Loreton/pressControl/Kicad/2025/pdf/PressControl_ESP32_2relay.pdf

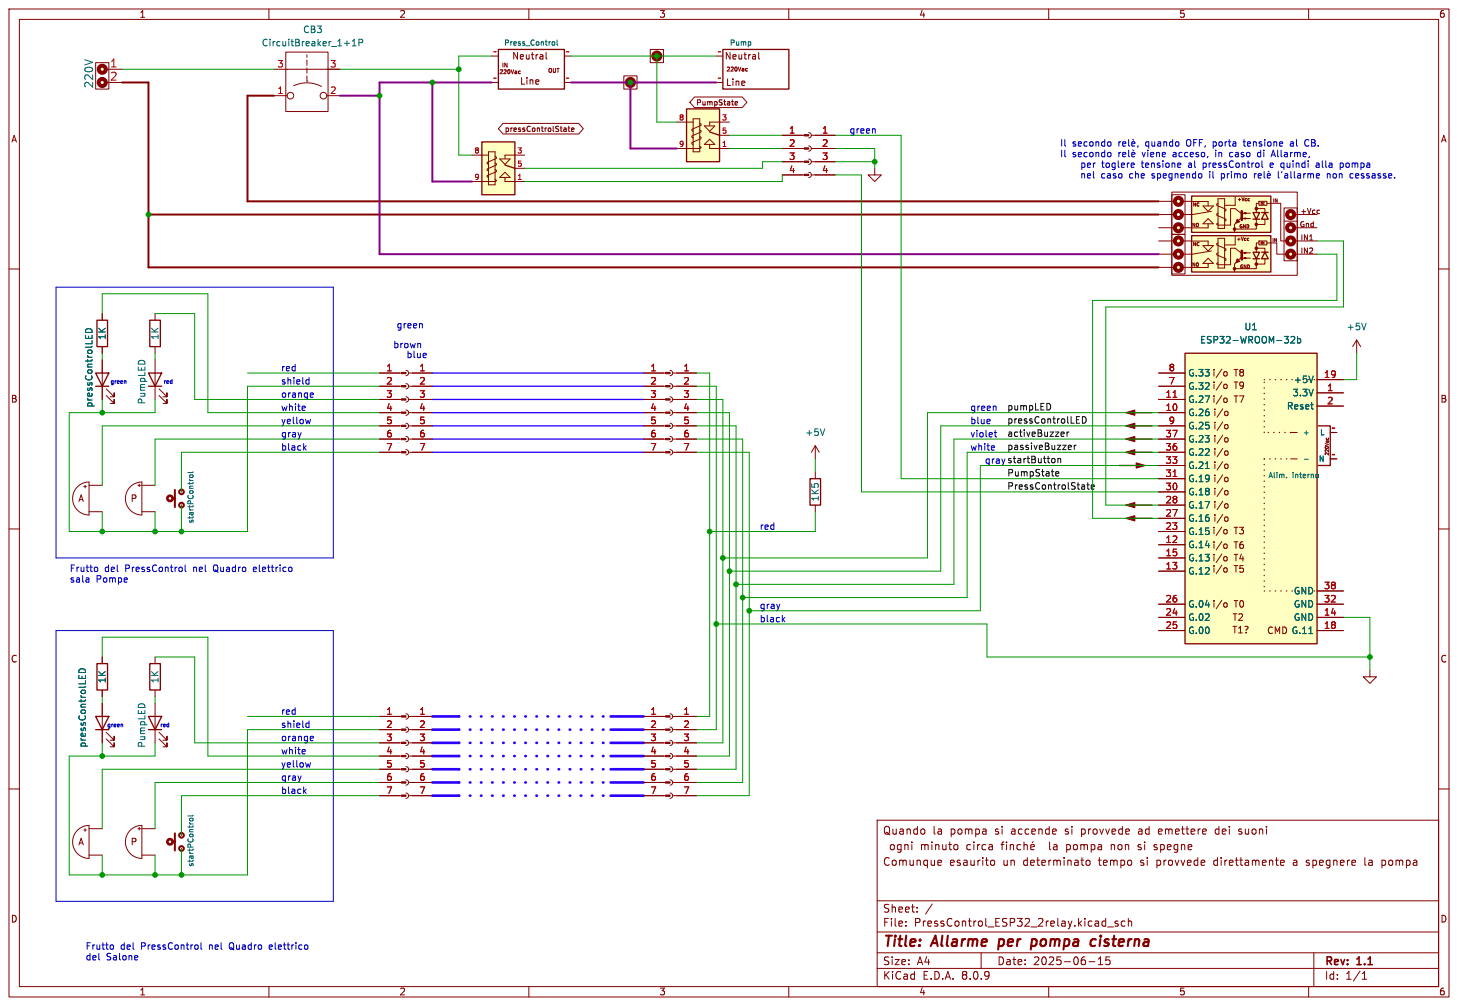
[picture p1: page 1]

Il secondo þÿrelè, quando OFF, porta tensione al CB.

Id: 1/1 Title: Allarme per pompa cisterna
