Loreton/pressControl/Kicad/2024/pdf/PressControl_vanoPompe_20240917.pdf

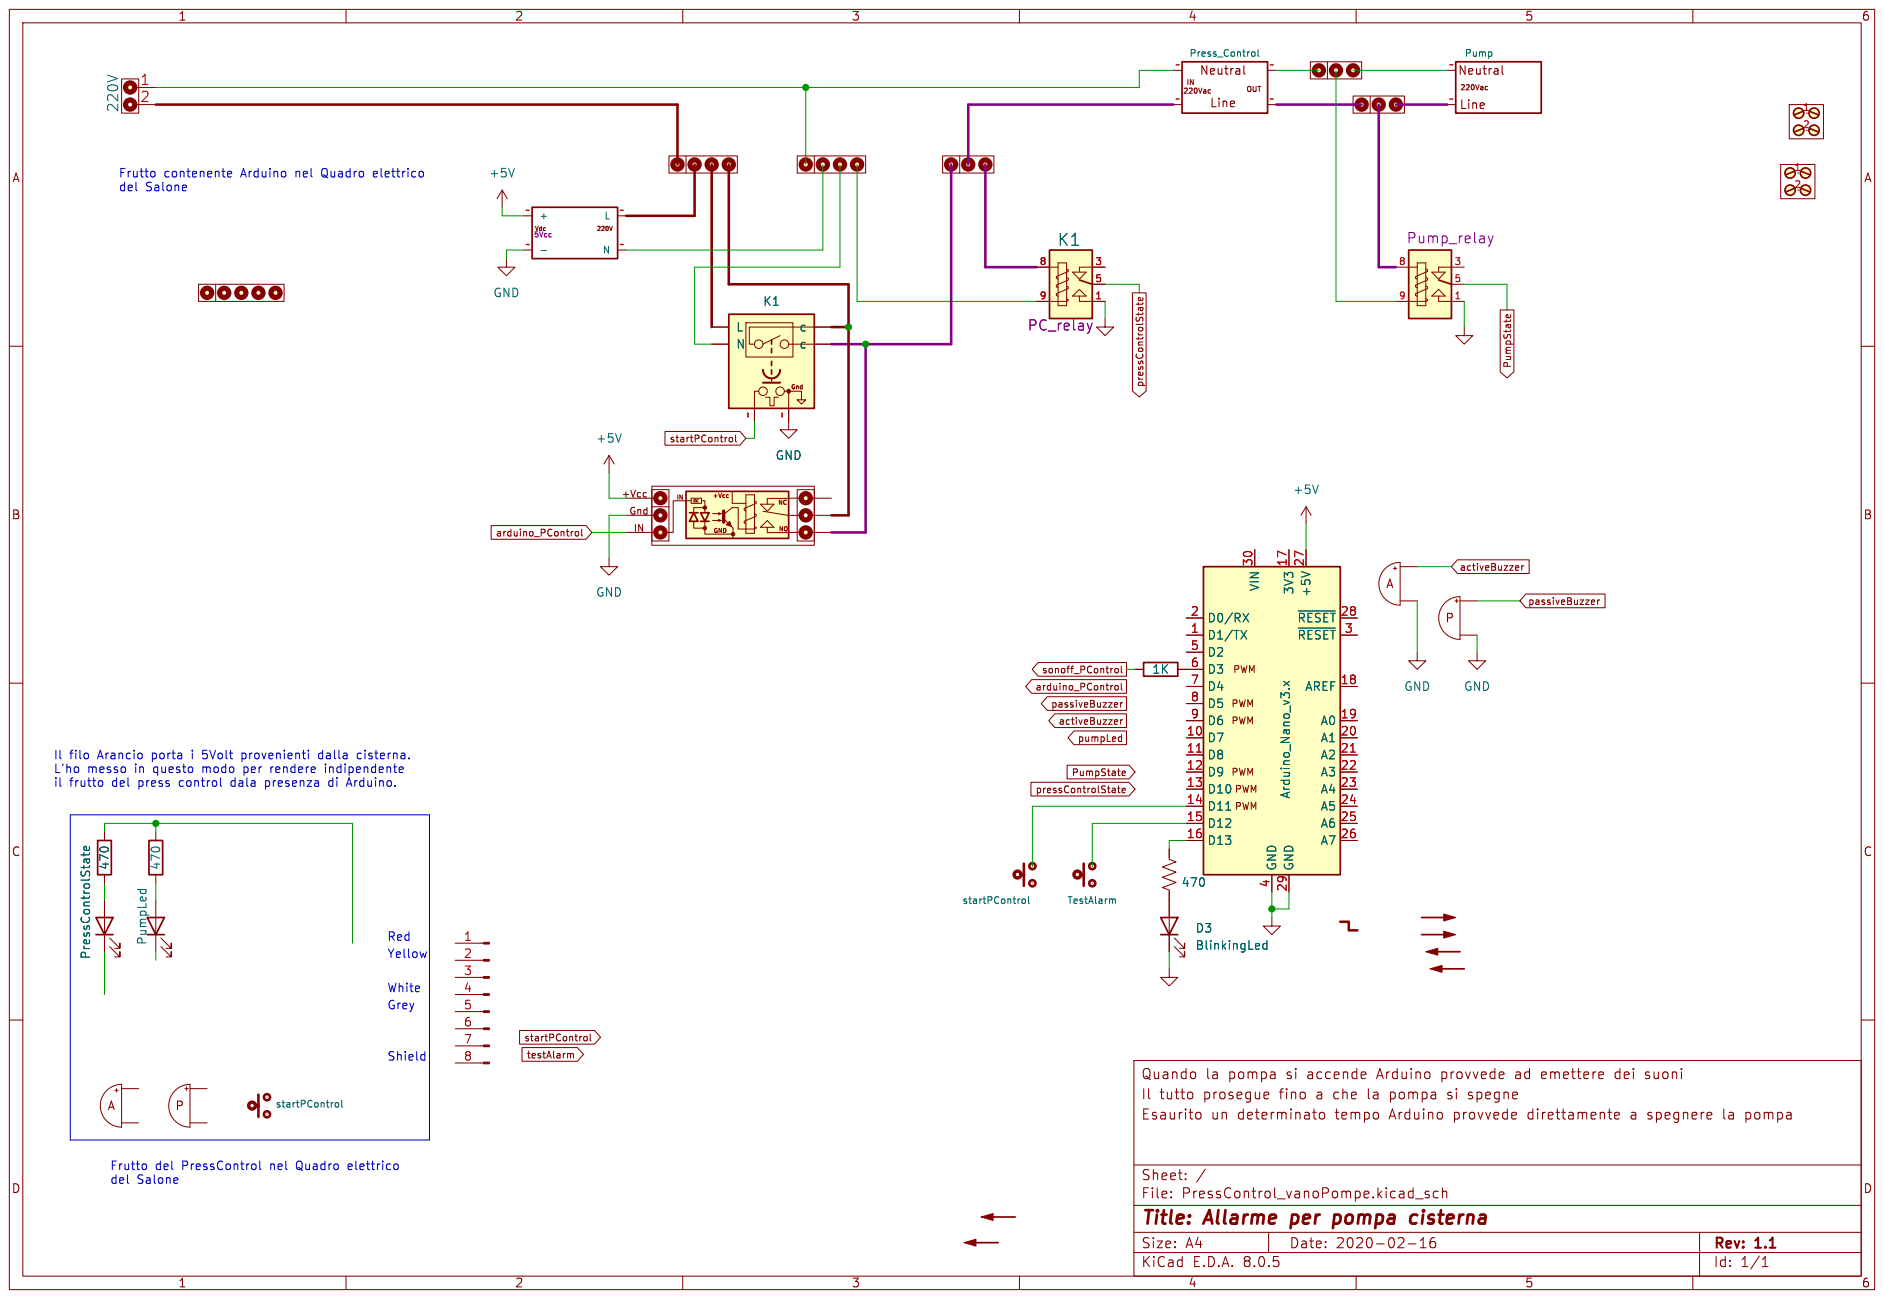
[picture p3: page 1]

R+Vcc +Vcc GND Gnd

Id: 1/1 Title: Allarme per pompa cisterna
