Loreton/pressControl/Kicad/2024/pdf/PressControl.pdf

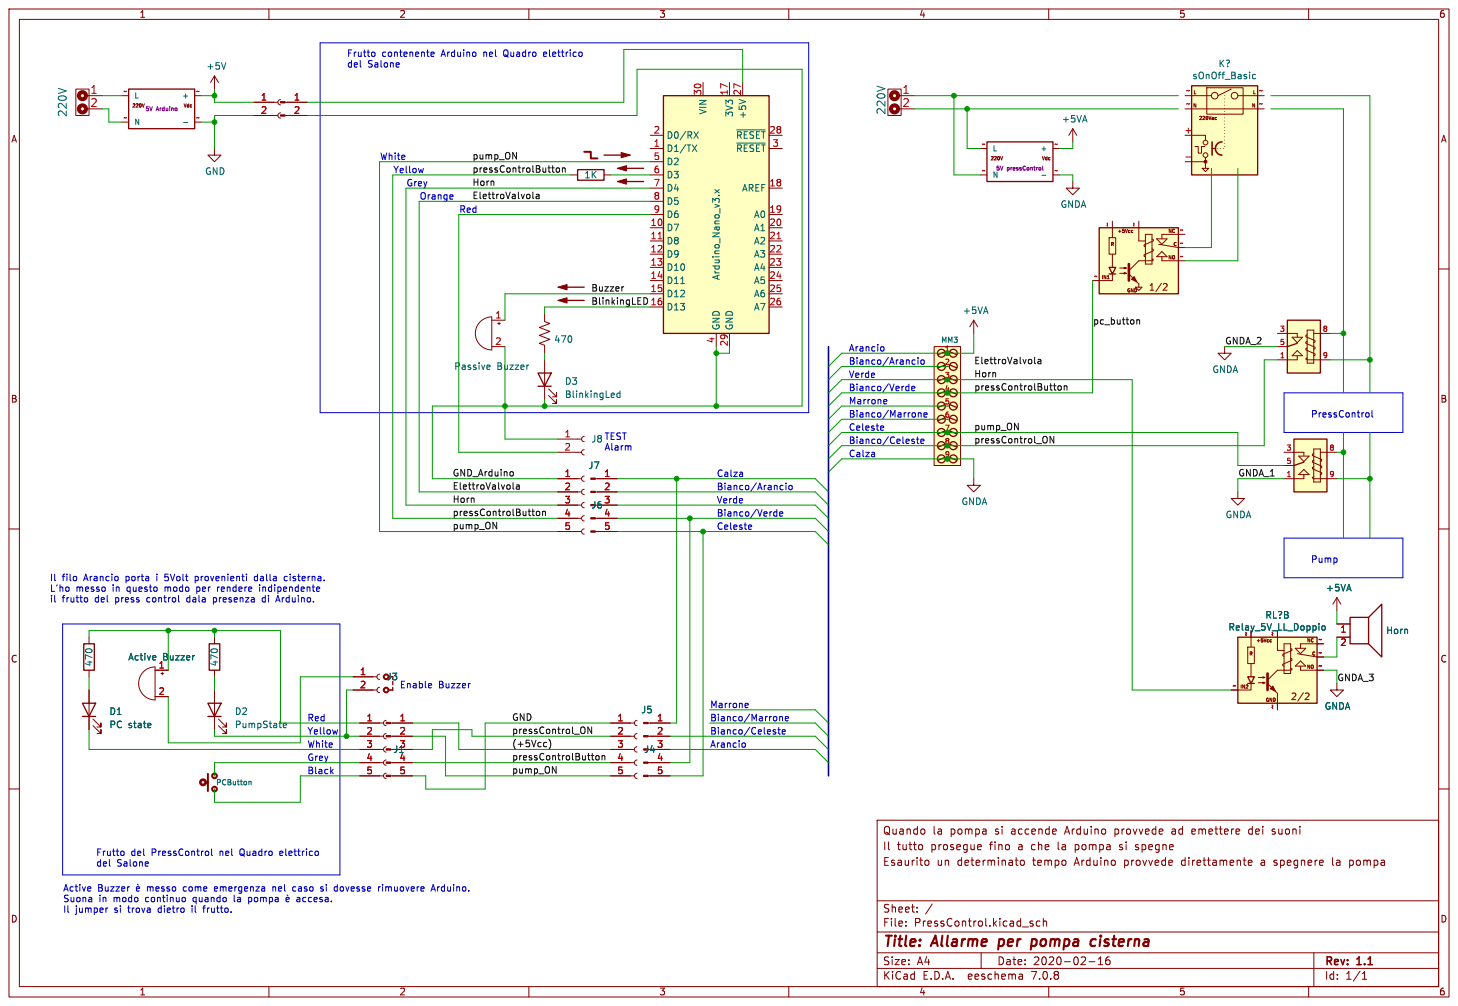
[picture p5: page 1]

Bianco/Arancio Bianco/Marrone Calza Bianco/Celeste Celeste

Il jumper si trova dietro il frutto.

Id: 1/1 Title: Allarme per pompa cisterna
