Loreton/pressControl/Kicad/2025/PressControl_ESP32_2relay.kicad_sch

## KiCad design Kicad/2025/PressControl_ESP32_2relay.kicad_sch (2025-08-08)

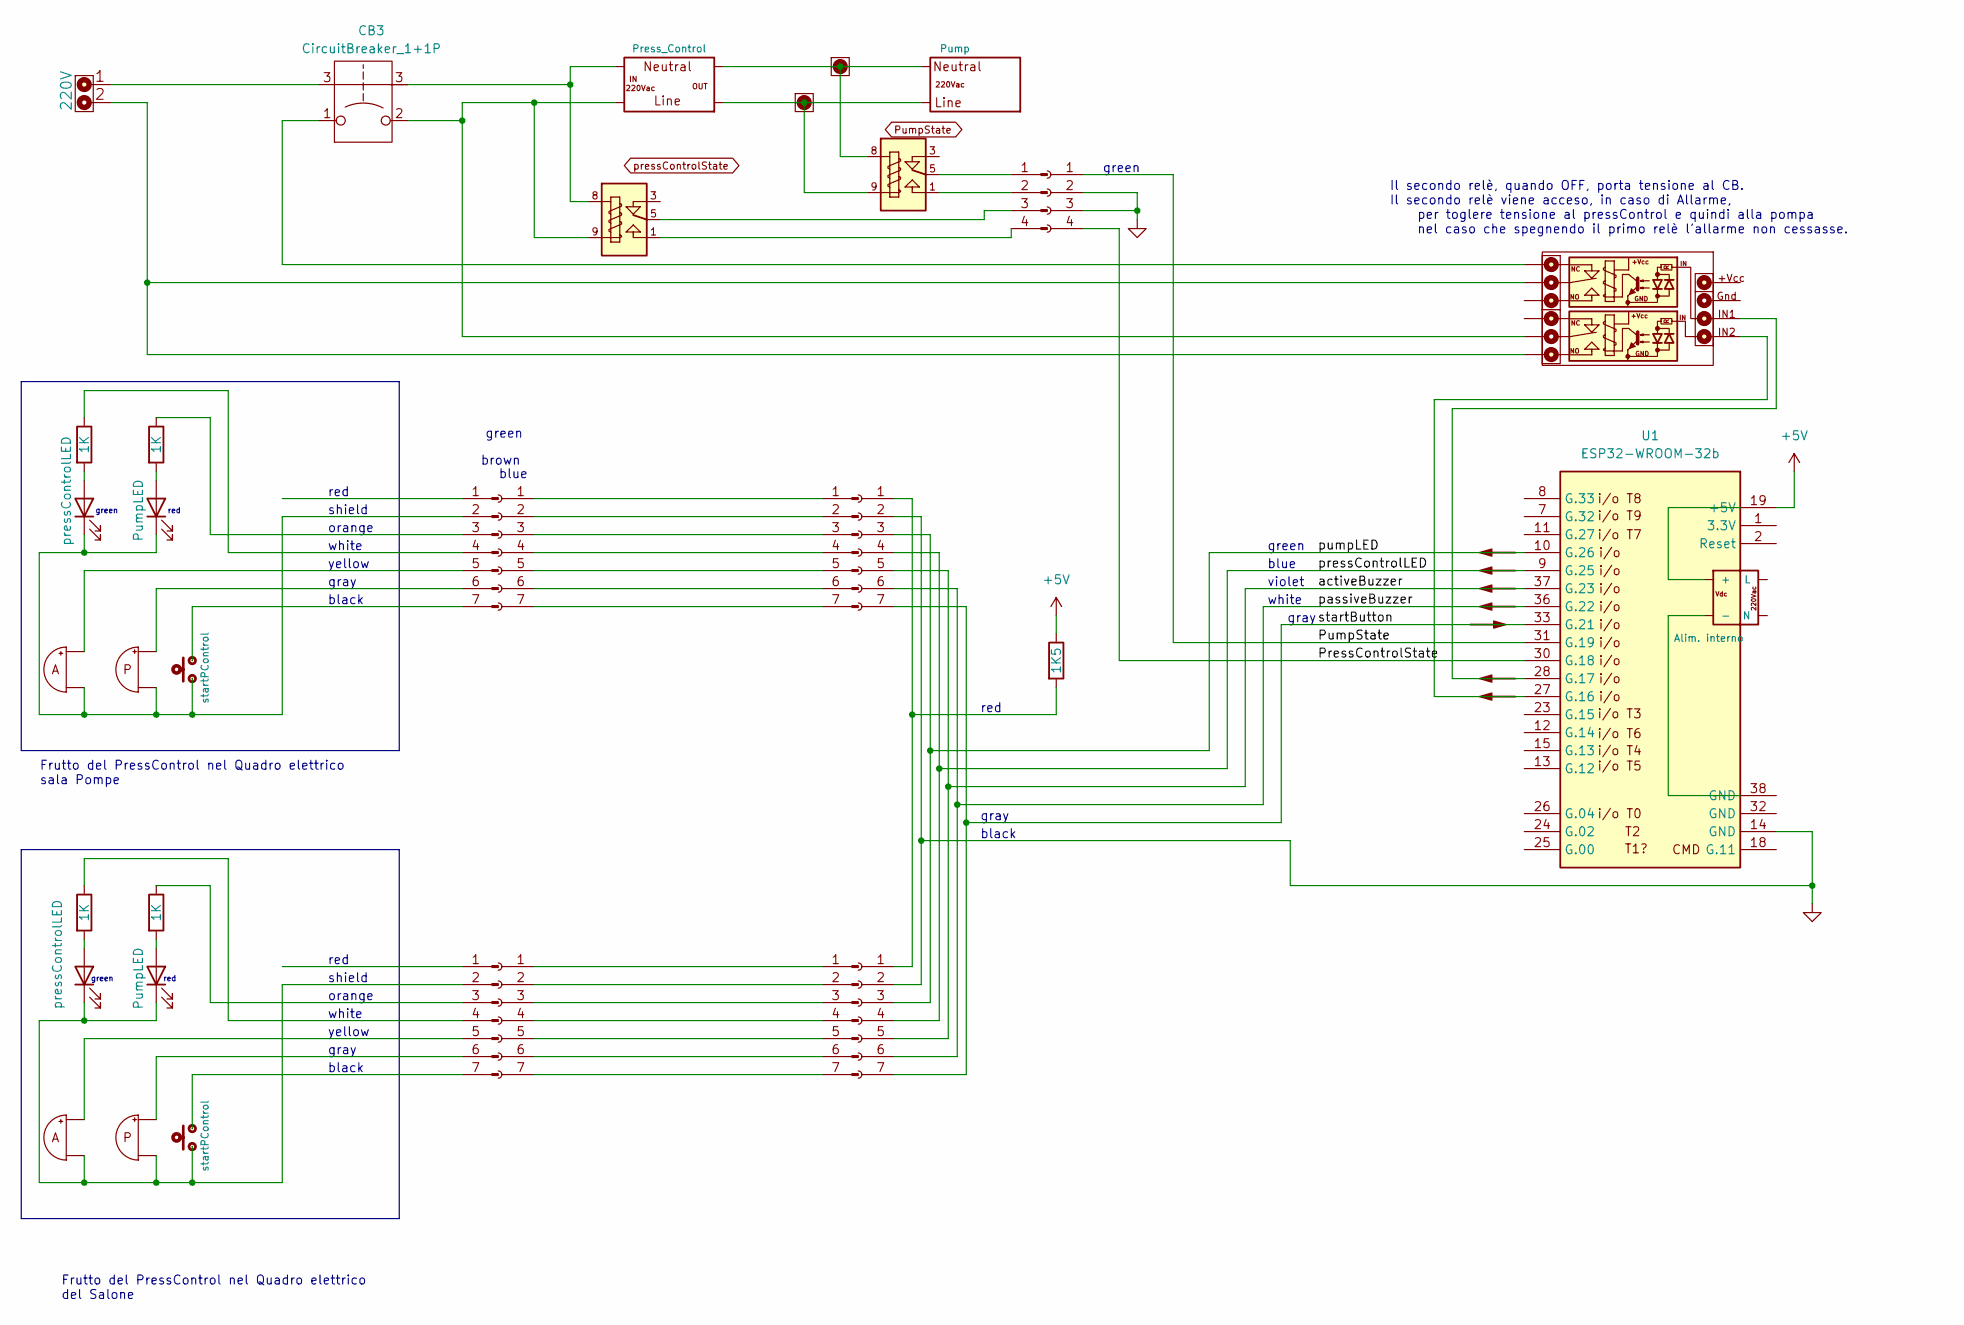
[picture p7: schematic PressControl_ESP32_2relay.kicad_sch]

Parts:
Al2: Alim. interno
BZ1, BZ3: Buzzer Active
BZ2, BZ4: Buzzer
CB3: CircuitBreaker_1+1P
D1, D4: pressControlLED
D2, D5: PumpLED
J1, J3, J9, J14, J16: Conn_01x08_Pin
J2, J8, J10, J11, J15: Conn_01x08_Socket
J12, J13: SIP_01
K1, K2: RELAY_1RT
K3: Relayx2_Module
P1: Pump
P2: Press_Control
R1, R3, R5, R6: 1K
R4: 1K5
SW2, SW3: startPControl
U1: ESP32-WROOM-32b; ESP32-WROOM-32

Connections:
+5V: R4.1, U1.19 (+5V)
GND: J2.2, J2.3, J10.2, J11.2, U1.14 (GND)
unnamed: BZ1., BZ2., D1.1 (K), D2.1 (K), J3.2, J3.5, SW3.1
unnamed: BZ2., J3.6
unnamed: BZ3., BZ4., D4.1 (K), D5.1 (K), J9.2, J9.5, SW2.1
unnamed: BZ4., J9.6
unnamed: CB3.1, K3.1
unnamed: CB3.2, K1.9, K3.2, P2.~
unnamed: CB3.3, K1.8, P2.~
unnamed: D1.2 (A), R3.2
unnamed: D2.2 (A), R5.2
unnamed: D4.2 (A), R1.2
unnamed: D5.2 (A), R6.2
unnamed: J1.1, K2.5 (C1)
unnamed: J1.2, K2.1 (T1)
unnamed: J1.3, K1.5 (C1)
unnamed: J1.4, K1.1 (T1)
unnamed: J3.3, R5.1
unnamed: J3.4, R3.1
unnamed: J3.7, SW3.2
unnamed: J9.3, R6.1
unnamed: J9.4, R1.1
unnamed: J9.7, SW2.2
unnamed: J10.1, J11.1, R4.2
unnamed: J12.1, K2.9, P1.~, P2.~
unnamed: J13.1, K2.8, P1.~, P2.~
unnamed: J14.1, J15.1
unnamed: J14.2, J15.2
unnamed: J14.3, J15.3
unnamed: J14.4, J15.4
unnamed: J14.5, J15.5
unnamed: J14.6, J15.6
unnamed: J14.7, J15.7
unnamed: J8.1, J16.1
unnamed: J8.2, J16.2
unnamed: J8.3, J16.3
unnamed: J8.4, J16.4
unnamed: J8.5, J16.5
unnamed: J8.6, J16.6
unnamed: J8.7, J16.7
unnamed: K3.2, K3.3
unnamed: K3.3, U1.28 (G.17)
unnamed: K3.4 (IN2), U1.27 (G.16)
PumpState: J2.1, U1.31 (G.19)
activeBuzzer: J10.5, J11.5, U1.37 (G.23)
passiveBuzzer: J10.6, J11.6, U1.36 (G.22)
pressControlLED: J10.4, J11.4, U1.9 (G.25)
pressControlState: J2.4, U1.30 (G.18)
pumpLED: J10.3, J11.3, U1.10 (G.26)
startButton: J10.7, J11.7, U1.33 (G.21)

Notes on the sheet:
red
violet
green
gray
white
Il secondo relè, quando OFF, porta tensione al CB. Il secondo relè viene acceso, in caso di Allarme, per toglere tensione al pressControl e quindi alla pompa nel caso che spegnendo il primo relè l'allarme non cessasse.
shield
black
black
Frutto del PressControl nel Quadro elettrico sala Pompe
blue
brown
orange
yellow
red
Frutto del PressControl nel Quadro elettrico del Salone
