Loreton/pressControl/Kicad/2024/prev/PressControl_V2.kicad_sch

## KiCad design Kicad/2024/prev/PressControl_V2.kicad_sch (2025-04-18)

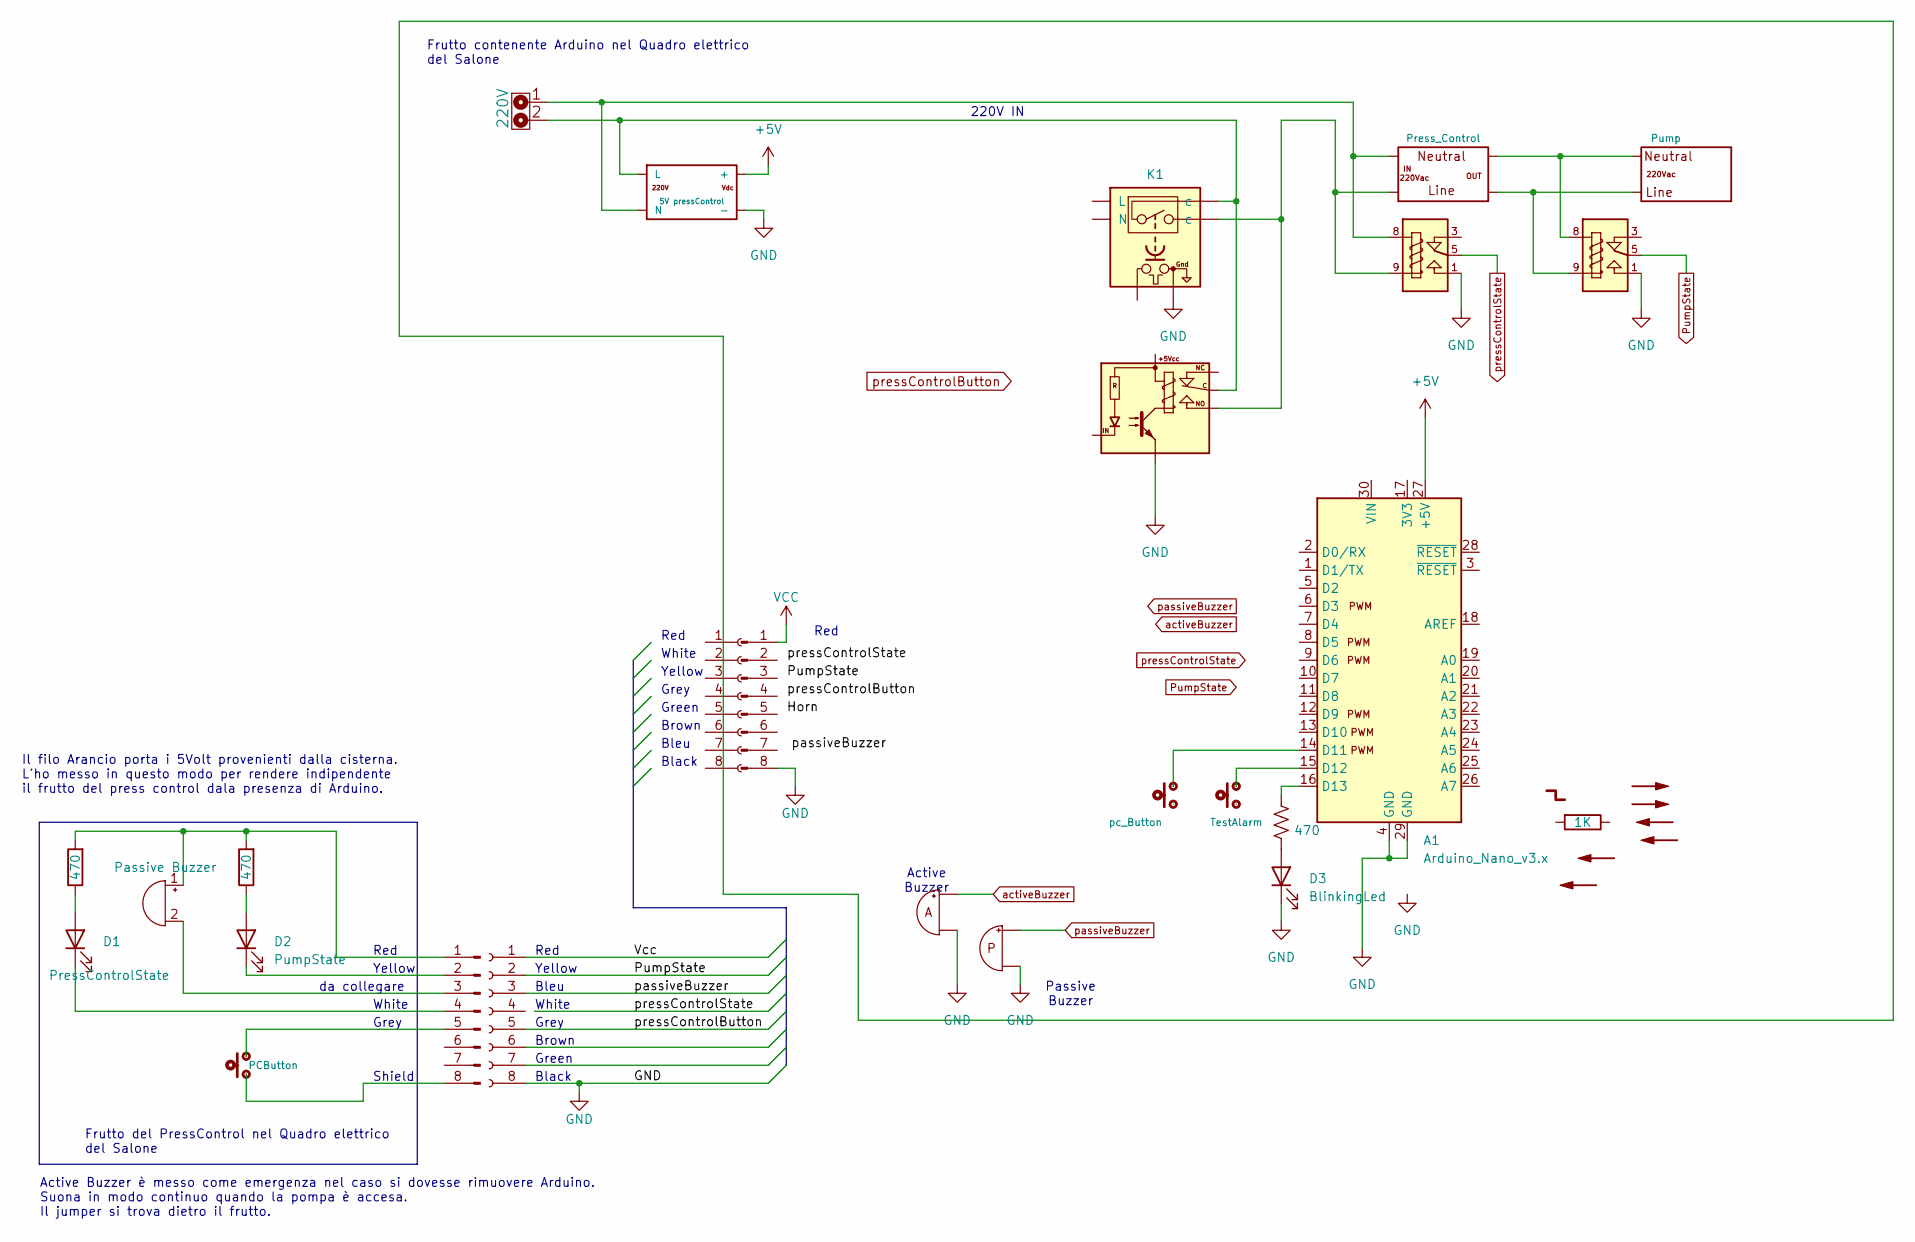
[picture p8: schematic PressControl_V2.kicad_sch]

Parts:
A1: Arduino_Nano_v3.x; Arduino_Nano
BZ1: Passive Buzzer
BZ3: Buzzer Active
BZ4: Buzzer
D1: PressControlState
D2: PumpState
D3: BlinkingLed
J1, J6: Conn_01x08_Pin
J2, J5: Conn_01x08_Socket
K1: sOnOff_ClearContacts
P1: Pump
P2: Press_Control
RL1: Relay_5V_LL
SW1: TestAlarm
SW2: pc_Button

Connections:
+5V: A1.27 (+5V)
GND: A1.4 (GND), A1.29 (GND), BZ3., BZ4., D3.1 (K), J2.8, J6.8, K1.~, RL1.~
unnamed: A1.14 (D11), SW2.2
unnamed: A1.15 (D12), SW1.2
unnamed: BZ1.1 (-), J1.1
unnamed: BZ1.2 (+), J1.3
unnamed: D1.1 (K), J1.4
unnamed: D2.1 (K), J1.2
unnamed: K1. (L), P2.~, RL1.~
unnamed: P1.~, P2.~
PumpState: J2.2
Vcc: J2.1, J6.1
activeBuzzer: BZ3.
passiveBuzzer: BZ4., J2.3
pressControlButton: J2.5

Notes on the sheet:
Brown
220V IN
da collegare
Red
Frutto del PressControl nel Quadro elettrico del Salone
White
Yellow
Grey
Bleu
Passive Buzzer
Green
Frutto contenente Arduino nel Quadro elettrico del Salone
Active Buzzer è messo come emergenza nel caso si dovesse rimuovere Arduino. Suona in modo continuo quando la pompa è accesa. Il jumper si trova dietro il frutto.
Il filo Arancio porta i 5Volt provenienti dalla cisterna. L'ho messo in questo modo per rendere indipendente il frutto del press control dala presenza di Arduino.
Shield
Active Buzzer
Black
Red
