Loreton/pressControl/Kicad/2024/prev/PressControl_con_Alim_v2.kicad_sch

## KiCad design Kicad/2024/prev/PressControl_con_Alim_v2.kicad_sch (2025-04-18)

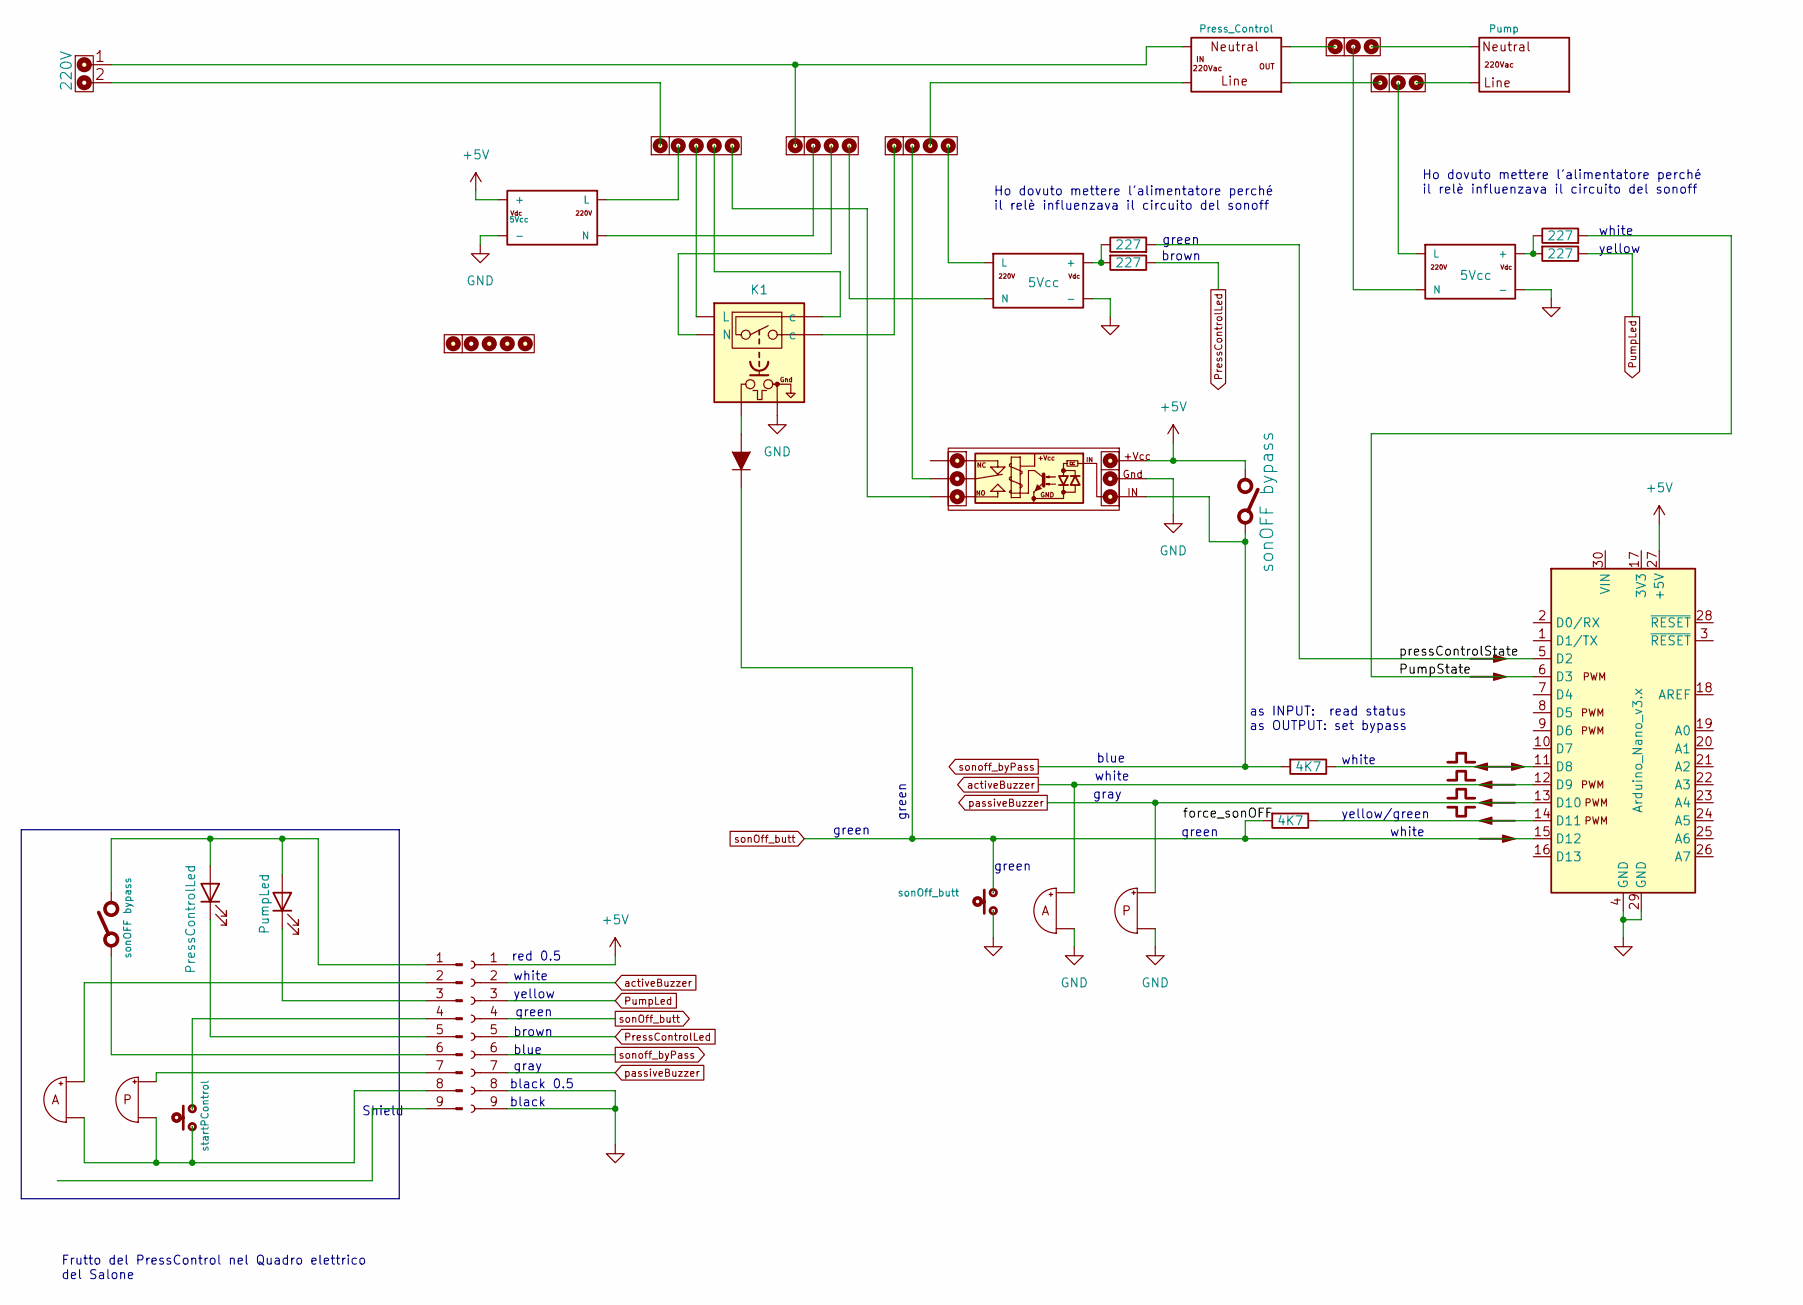
[picture p9: schematic PressControl_con_Alim_v2.kicad_sch]

Parts:
A1: Arduino_Nano_v3.x; Arduino_Nano
Al_5Vcc1, Al_5Vcc2: Alimentatore; 5Vcc
BZ1, BZ3: Buzzer Active
BZ2, BZ4: Buzzer
D1: PressControlLed
D2: PumpLed
D4: DIODE
J1, J2, J4, J5, J6: SIP_05
J3: Conn_01x08_Pin
J7: SIP_04
J10: Conn_01x08_Socket
K1: sOnOff_ClearContacts
K2: Relayx1_Module
P1: Pump
P2: Press_Control
R1, R3, R4, R5: 227
R7: 4K7
SW2: sonOff_butt
SW3: startPControl
SW4, SW5: sonOFF bypass
SW6, SW7, SW8, SW9: Pulse

Connections:
+5V: A1.27 (+5V), J10.1, K2.1, SW4.2
GND: A1.4 (GND), A1.29 (GND), Al_5Vcc1.~, Al_5Vcc2.~, BZ3., BZ4., J10.8, J10.9, K1.~, K2.2, SW2.1
unnamed: A1.11 (D8), R7.1
unnamed: Al_5Vcc1.~, J2.4, J4.4, R3.2, R5.1
unnamed: Al_5Vcc2.~, J5.2, J6.2, R1.1, R4.2
unnamed: BZ1., BZ2., J3.2, J3.8, SW3.1
unnamed: BZ2., J3.7
unnamed: D1.1 (K), J3.5
unnamed: D1.2 (A), D2.2 (A), J3.1, SW5.2
unnamed: D2.1 (K), J3.3
unnamed: D4.1 (A), K1.~
unnamed: J2.1, K1. (L)
unnamed: J2.2, K2.2
unnamed: J2.3, P2.~
unnamed: J3.4, SW3.2
unnamed: J3.6, SW5.1
unnamed: J4.1, P2.~
unnamed: J4.3, K1. (L)
unnamed: J5.1, P2.~
unnamed: J5.3, P1.~
unnamed: J6.1, P2.~
unnamed: J6.3, P1.~
unnamed: J7.3, K1. (L)
unnamed: J7.4, K1. (L)
unnamed: J7.5, K2.3
PressControlLed: J10.5, R3.1
PumpLed: J10.3, R4.1
PumpState: A1.6 (D3), R1.2
activeBuzzer: A1.12 (D9), BZ3., J10.2
passiveBuzzer: A1.13 (D10), BZ4., J10.7
pressControlState: A1.5 (D2), R5.2
sonOff_butt: A1.15 (D12), D4.2 (K), J10.4, SW2.2
sonoff_byPass: J10.6, K2.3, R7.2, SW4.1

Notes on the sheet:
green
white
yellow/green
as INPUT: read status as OUTPUT: set bypass
brown
black
black 0.5
Ho dovuto mettere l'alimentatore perché il relè influenzava il circuito del sonoff
gray
yellow
red 0.5
blue
Shield
Frutto del PressControl nel Quadro elettrico del Salone
