Loreton/pressControl/Kicad/2024/prev/PressControl_vanoPompe.kicad_sch

## KiCad design Kicad/2024/prev/PressControl_vanoPompe.kicad_sch (2025-04-18)

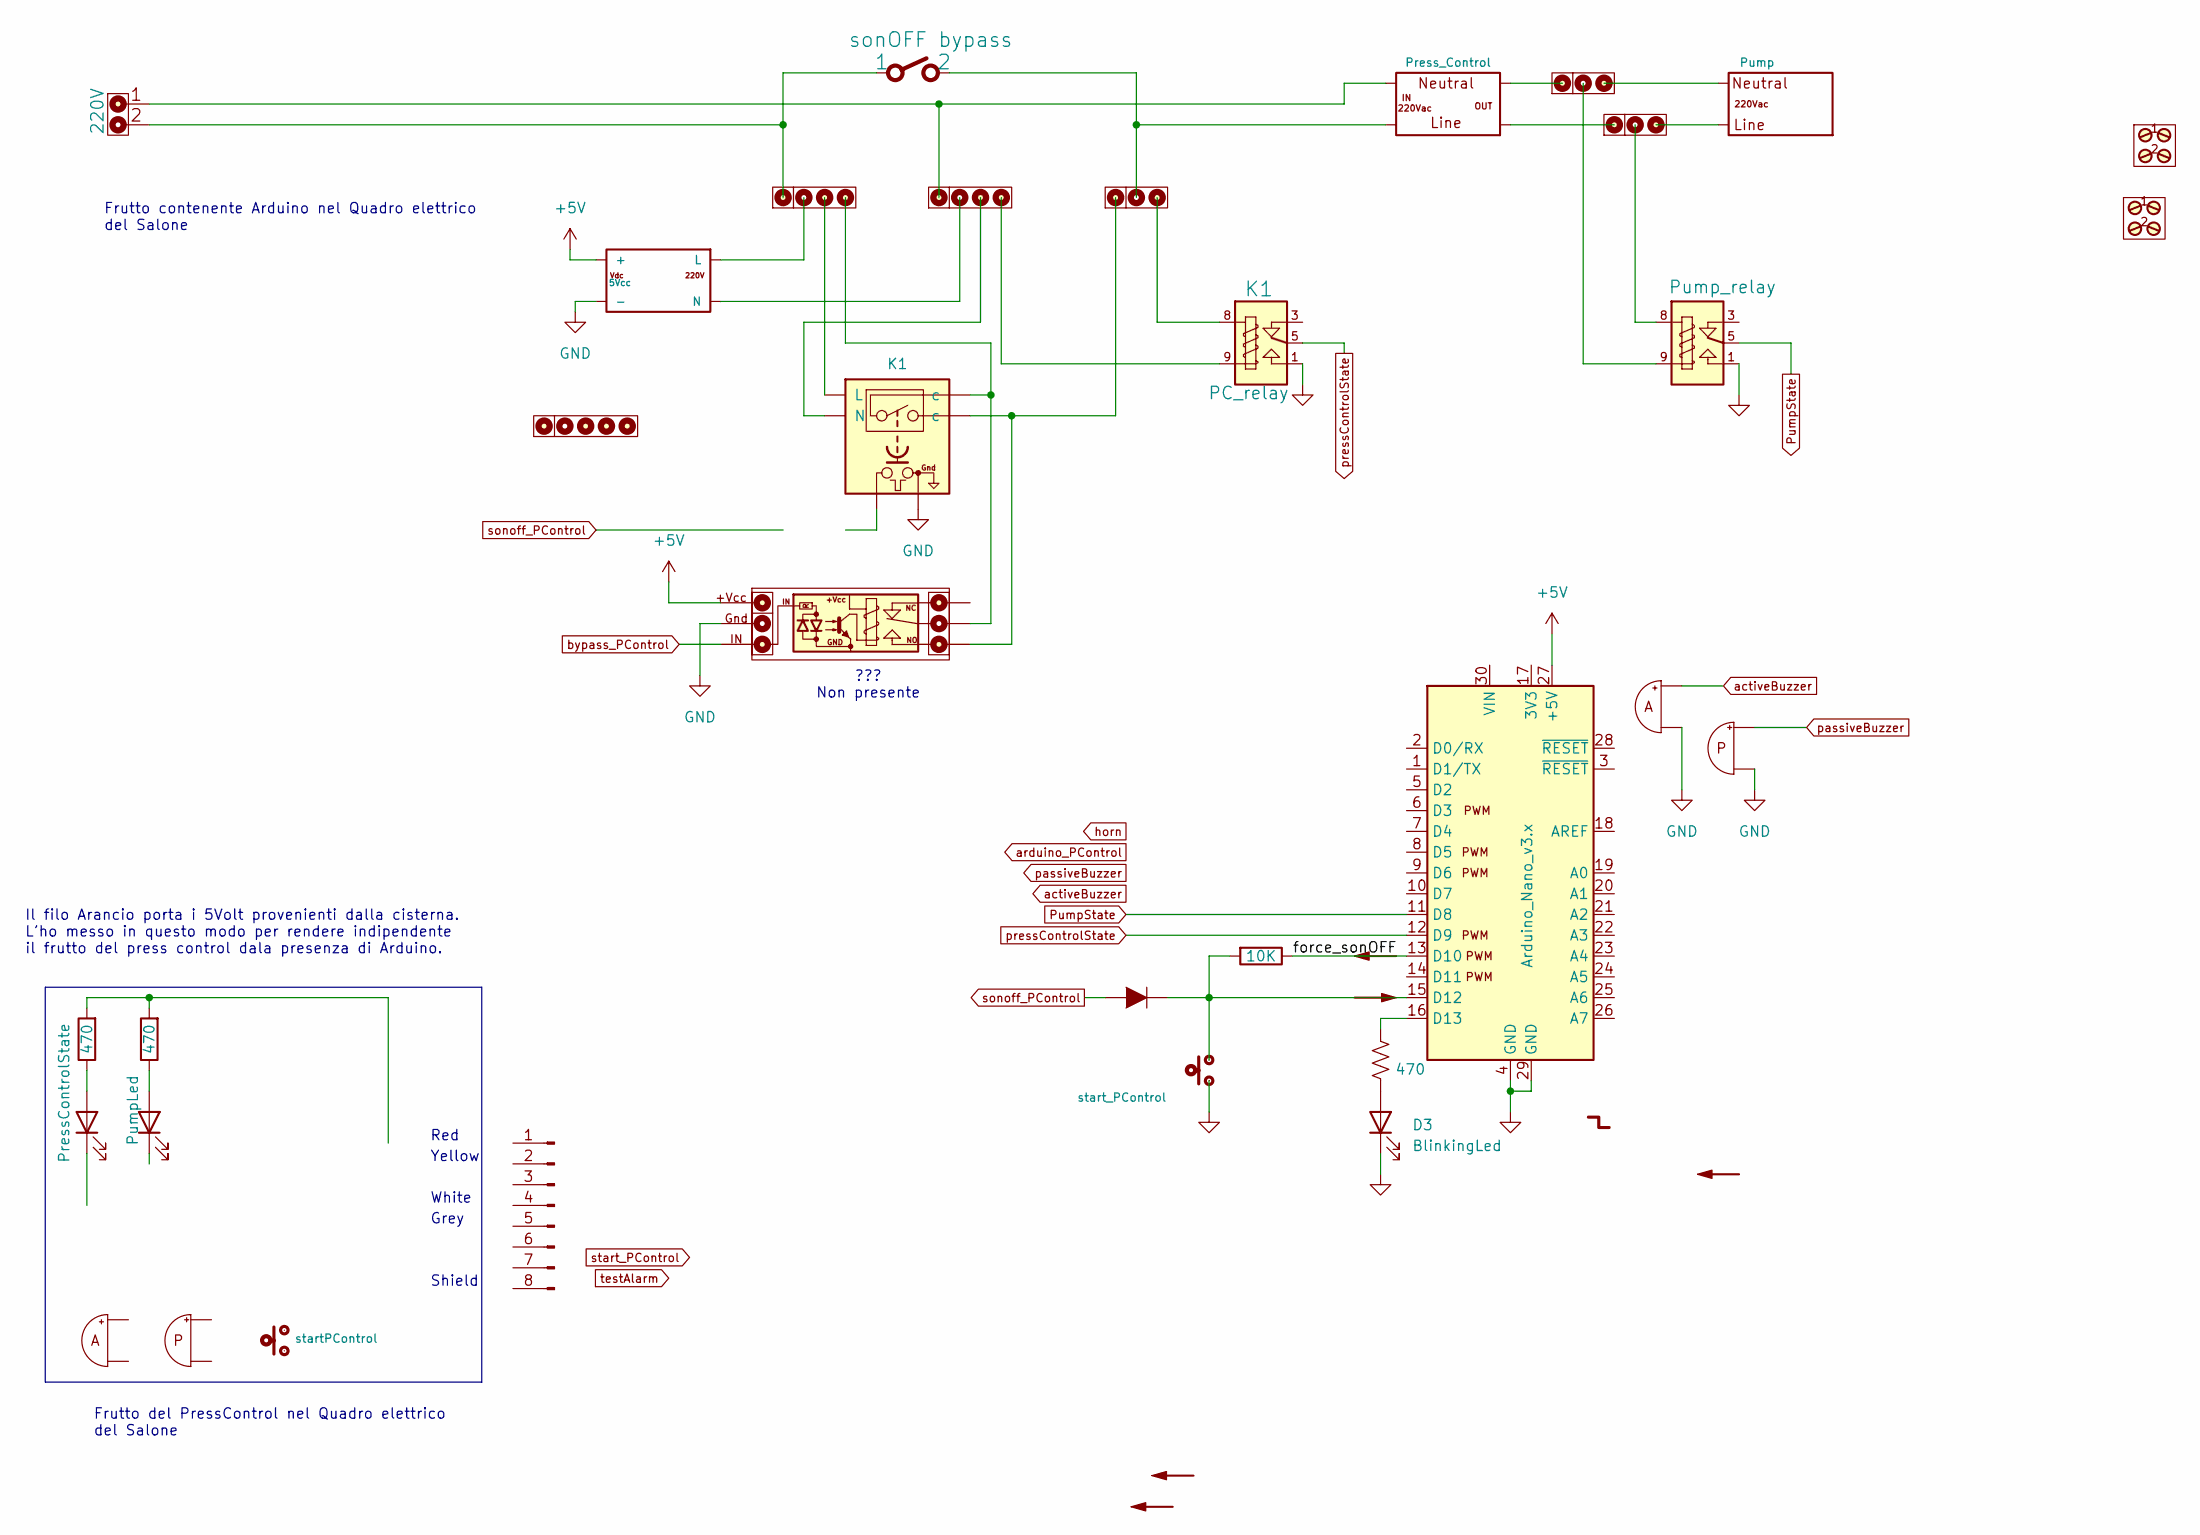
[picture p10: schematic PressControl_vanoPompe.kicad_sch]

Parts:
A1: Arduino_Nano_v3.x; Arduino_Nano
BZ1, BZ3: Buzzer Active
BZ2, BZ4: Buzzer
D1: PressControlState
D2: PumpLed
D3: BlinkingLed
D4: DIODE
J1, J2, J4, J5, J6: SIP_05
J3: Conn_01x08_Pin
J7: SIP_04
K1: RELAY_2RT; PC_relay
K2: Relayx1_Module
MM1, MM2: Mammuth_02a
P1: Pump
P2: Press_Control
R1, R2: 470
SW1: sonOFF bypass
SW2: start_PControl
SW3: startPControl

Connections:
+5V: A1.27 (+5V), K2.1
GND: A1.4 (GND), A1.29 (GND), BZ3., BZ4., D3.1 (K), K1.1 (T1), K1.~, K2.2, SW2.1
unnamed: A1.15 (D12), D4.2 (K), SW2.2
unnamed: D1.2 (A), R1.1
unnamed: D2.2 (A), R2.1
unnamed: J2.1, K1. (L), K2.3
unnamed: J2.2, P2.~, SW1.2
unnamed: J2.3, K1.8
unnamed: J4.1, P2.~
unnamed: J4.3, K1. (L)
unnamed: J4.4, K1.9
unnamed: J5.1, P2.~
unnamed: J5.3, P1.~
unnamed: J6.1, P2.~
unnamed: J6.3, P1.~
unnamed: J7.1, SW1.1
unnamed: J7.3, K1. (L)
unnamed: J7.4, K1. (L), K2.2
unnamed: R1.2, R2.2
PumpState: A1.11 (D8)
activeBuzzer: BZ3.
bypass_PControl: K2.3
force_sonOFF: A1.13 (D10)
passiveBuzzer: BZ4.
pressControlState: A1.12 (D9), K1.5 (C1)
sonoff_PControl: D4.1 (A)

Notes on the sheet:
White
??? Non presente
Yellow
Red
Frutto contenente Arduino nel Quadro elettrico del Salone
Grey
Il filo Arancio porta i 5Volt provenienti dalla cisterna. L'ho messo in questo modo per rendere indipendente il frutto del press control dala presenza di Arduino.
Shield
Frutto del PressControl nel Quadro elettrico del Salone
