Loreton/pressControl/a_pressControlLib/relayManager_Class/relayManager_Class.h

//
// updated by ...: Loreto Notarantonio
// Date .........: 16-08-2025 16.21.56
//

#pragma once

#include <Arduino.h> // Necessario per funzioni come pinMode, digitalWrite, millis

class RelayManager_Class {
    private:
        uint8_t             m_pin = 99;
        const char* m_name  = nullptr;
        char                m_pinID[21];        // [pin_name.pin_nr]:

        uint8_t             m_activeLevel = LOW; // Livello che attiva il relè (HIGH o LOW)
        uint8_t             m_On = LOW;         // Livello per lo stato ON (dipende da m_activeLevel)
        uint8_t             m_Off = LOW;        // Livello per lo stato OFF (dipende da m_activeLevel)

        uint32_t            m_pulseStartTime = 0;
        uint32_t            m_pulseDuration = 0;

        bool                m_pulseActive = false;
        bool                m_relayState = false; // Stato logico del relè (true = acceso, false = spento)

        /**
         * Se timeBuffer è statica e globale.
         * Ogni chiamata a timeStamp sovrascrive il contenuto di timeBuffer,
         * quindi quando stampi più valori nello stesso printf,
         * entrambe le chiamate restituiscono il valore dell'ultima chiamata
         * per tale ragione il buffer deve essere allocato estrnamente
         * ....oppure prestare molta attenzione
        */
        char                m_timeBUFFER[16];
        uint8_t             m_timeBUFFER_Len = sizeof(m_timeBUFFER);
        // Imposta lo stato fisico del relè sul pin
        void setRelay(bool state);

    public:
        // Costruttore
        RelayManager_Class();

        // --- Metodi Pubblici ---
        void init(const char *name, uint8_t pin, uint8_t activationLevel);

        // Accende il relè
        void on();
        // Spegne il relè
        void off();
        // Inverte lo stato del relè
        void toggle();

        // Avvia un pulsetime per il relè
        // duration_ms: Durata del pulsetime in millisecondi.
        void startPulse(uint32_t duration_ms);

        // Ottiene il tempo rimanente del pulsetime (0 se non attivo o scaduto)
        uint32_t getRemainingPulseTime();

        // Deve essere chiamata regolarmente nel loop() per aggiornare lo stato del relè
        void update();

        // Ritorna lo stato logico attuale del relè (true = acceso, false = spento)
        bool state() const;
        // Ritorna vero se il relè è fisicamente attivo (a livello di pin)
        bool isActive() const;

        // Ritorna l'ID del pin (utile per debug)
        // const char *pinID() const;
        inline const char* pinID(void) const { return m_pinID; }

    };
