Loreton/pressControl/a_pressControlLib/lnLogger_Class/noLogger.h

/*
// updated by ...: Loreto Notarantonio
// Date .........: 17-08-2025 07.52.20
*/

#pragma once

    // #include <Arduino.h>


    // #define LOG_DEBUG(...) do {} while (0)
    // #define LOG_INFO(...) do {} while (0)
    // #define LOG_SPEC(...) do {} while (0)
    // #define LOG_NOTIFY(...) do {} while (0)
    // #define LOG_WARN(...) do {} while (0)
    // #define LOG_ERROR(...) do {} while (0)
    // #define LOG_TRACE(...) do {} while (0)


    // // ANSI Color Definitions
    // namespace LogColors {
    //     const char* const RESET  = "\x1B[0m";
    //     const char* const RED    = "\x1B[1;31m";
    //     const char* const GREEN  = "\x1B[1;32m";
    //     const char* const YELLOW = "\x1B[1;33m";
    //     const char* const BLUE   = "\x1B[1;34m";
    //     const char* const PURPLE = "\x1B[1;35m";
    //     const char* const CYAN   = "\x1B[1;36m";
    //     const char* const WHITE  = "\x1B[1;37m";
    // } // namespace LogColors
