Loreton/pressControl/(commit log)

2025-04-18 'first commit'
    [PressControl_ESP32_2relay.kicad_sch, PressControl_V1.kicad_sch, PressControl_V2.kicad_sch, PressControl_con_Alim.kicad_sch, PressControl_con_Alim_v1.kicad_sch, PressControl_con_Alim_v2.kicad_sch, PressControl_remoto.kicad_sch, PressControl_vanoPompe.kicad_sch]
2025-05-28 'sembra la versione base funzionante. Ho dovuto mettere SSHCLIENT=false'
    [PressControl_ESP32_2relay.kicad_sch]
2025-06-15 first released version
    [PressControl_ESP32_2relay.kicad_sch]
2025-06-16 completato definizione struttura pin debounce
2025-06-19 solo bouncedButton e relay
2025-06-29 ripartiamo con button+relè
2025-06-30 inseriti led e active_buzzer
2025-07-29 migrato anche buttonLongPress to Class
2025-07-29 commentata parte di buttonLongPress_Struct
2025-07-29 completata migrazione di buttonLongPress_Struct
2025-07-29 modifiche per passare sempre i buffer di destinazione alle funzioni
2025-08-05 affinamento buttonLongPress_Class
2025-08-08 completato, senza rete, e con gestion del rele magnetotermico esterno
2025-08-08 update kicad
    [PressControl_ESP32_2relay.kicad_sch]
2025-08-23 spostamento del controllo wifi nel main.cpp e inserito LOG_MODULE_LEVEL nel logger per permettere il controllo modulare del logging
2025-08-28 LnTime_Class inserito utilizzo di std::map
2025-09-01 sembra consolidato con i controlli sui pin di pump e presscontrol e relays
2025-09-01 ulteriore consolidamento con i controlli sui pin di pump e presscontrol e relays
